mkirbst/lupo-gti-tripcomputer-kw1281/hardware/02-finish-lower-side.png

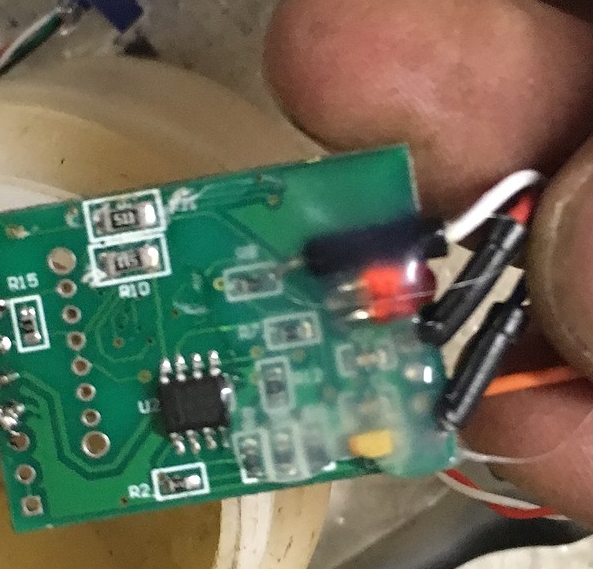
hardware/02-finish-lower-side.png
