mkirbst/lupo-gti-tripcomputer-kw1281/hardware/ftdi-pinout.jpg

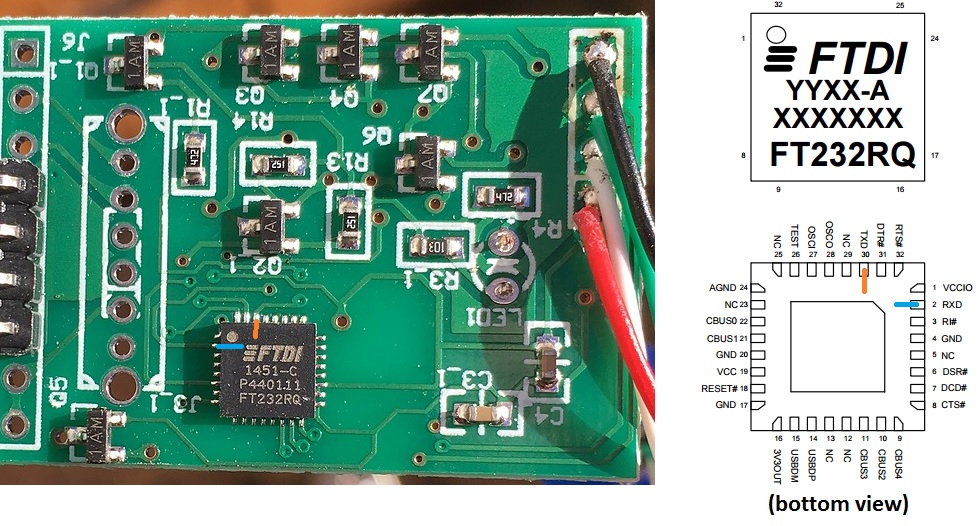
hardware/ftdi-pinout.jpg
