mkirbst/lupo-gti-tripcomputer-kw1281/hardware/tripcomputer-incl-gui-description.jpg

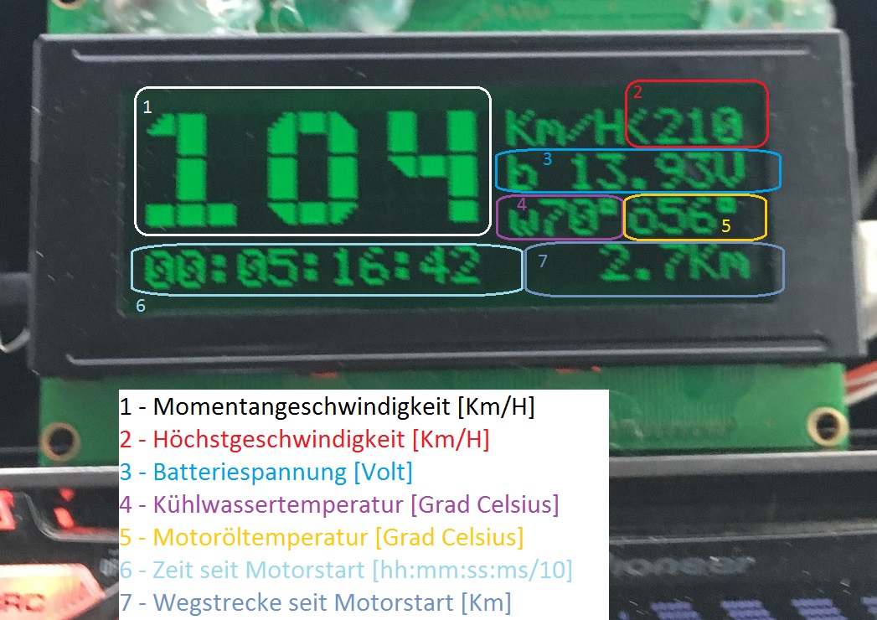
hardware/tripcomputer-incl-gui-description.jpg
